BKayCode/Wake-up-Light/(threads)

Thread 1 (2024-12-08):

Connection diagram for the esp

saz, 2024-12-08:
Hey there, thanks for this and your hard work. I'm also owning the same model and planning to use an ESP8266 or ESP32 to get some more intelligence into this thing.

After reading through your findings, I guess an ESP32 might be a better fit, due to the two ADC.

Can you provide some wiring diagram or more pictures of your current setup?

You're saying, that the light uses i2c, same for the front button part. Are you just connecting the esp in parallel on the display board?

BKayCode, 2024-12-08:
Hi Steffen,

das Board mit den ganzen Kabeln habe ich erstmal in die Lampe gestopft, da ich momentan noch bei den Sensorknöpfen der Vorderseite weitermachen möchte.
Da habe ich allerdings momentan Schwierigkeiten das I2C auszulesen.
Bilder sind also momentan schlecht, zumal ich die Lampe jetzt schon seit einiger Zeit morgens benutze. :D

Mein LOLIN D1 mini ist direkt mit dem Kabel verbunden, welches zu dem LED Treiber board geht.
24V kannst du direkt auf den Pin vom original Netzteil geben, 5V für den anderen Pin und das Lolinboard stellt ein MP1584.
Momentan sind die anderen Platinen (Powerboard mit dem Soundmodul und Radio, Sensorknöpfe sowie das LCD Board komplett draußen.

Sprich nur die LED ist verbunden und die seitlichen Knöpfe.

Ein ESP32 sollte auch funktionieren, dann könntest du dir den Aufwand mit dem analogen Multiplexer sparen.

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

Thread 2 (2025-01-25):

Wrong command for sunrise simulation for model HF3531

dmognaschi, 2025-01-25:
Dear BKayCode,
I have the HF3531 model and in my case the correct command to start the sunrise simulation ends with 0xFF, therefore:

Write0x51 0x00 0x02 REPSTART riseBrightness[0x01:0x14] riseMinutes[0x01:0x2D] 0xFF

Ciao!
Davide
